vipulgpt10/Digital-IC-Tester-and-Identifier/pics/13120489_1094352060622823_1292871912_o.jpg

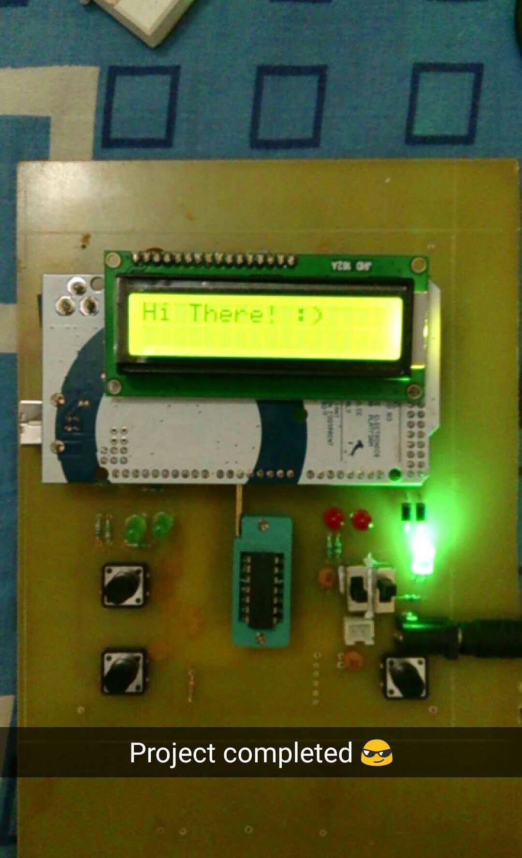
pics/13120489_1094352060622823_1292871912_o.jpg
