vipulgpt10/Digital-IC-Tester-and-Identifier/pics/13120432_1094352113956151_1493493609_o.jpg

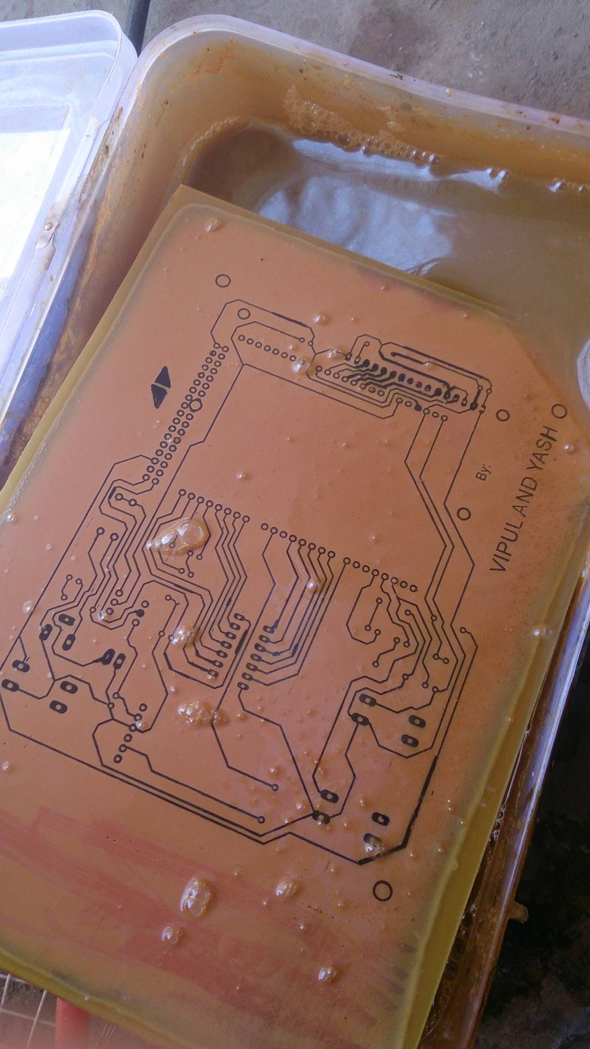
pics/13120432_1094352113956151_1493493609_o.jpg
