vipulgpt10/Digital-IC-Tester-and-Identifier/pics/13106560_1094352093956153_963681279_o.jpg

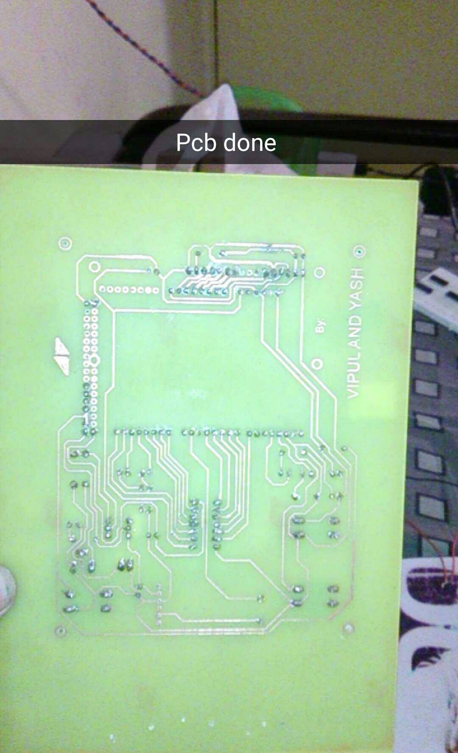
pics/13106560_1094352093956153_963681279_o.jpg
