vipulgpt10/Digital-IC-Tester-and-Identifier/pics/13120357_1094352080622821_129199084_o.jpg

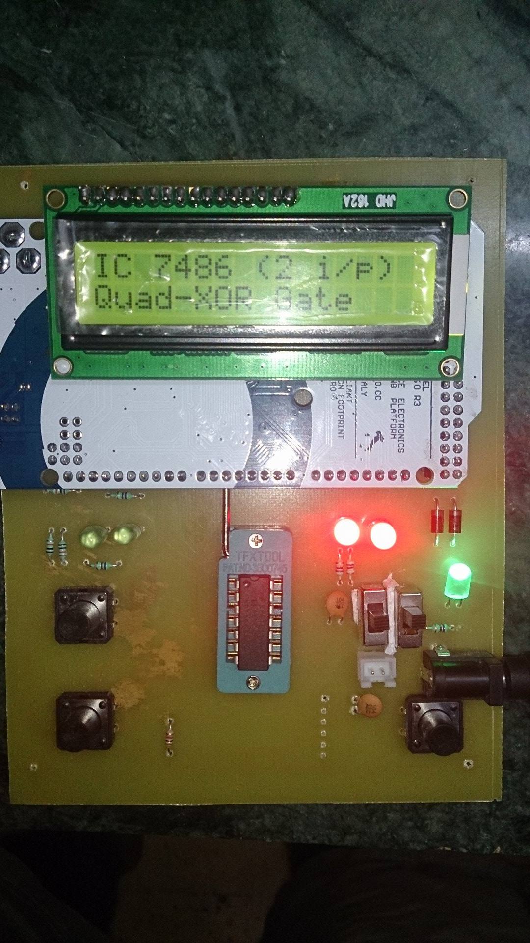
pics/13120357_1094352080622821_129199084_o.jpg
