vipulgpt10/Digital-IC-Tester-and-Identifier/pics/13120414_1094352140622815_749441663_o.jpg

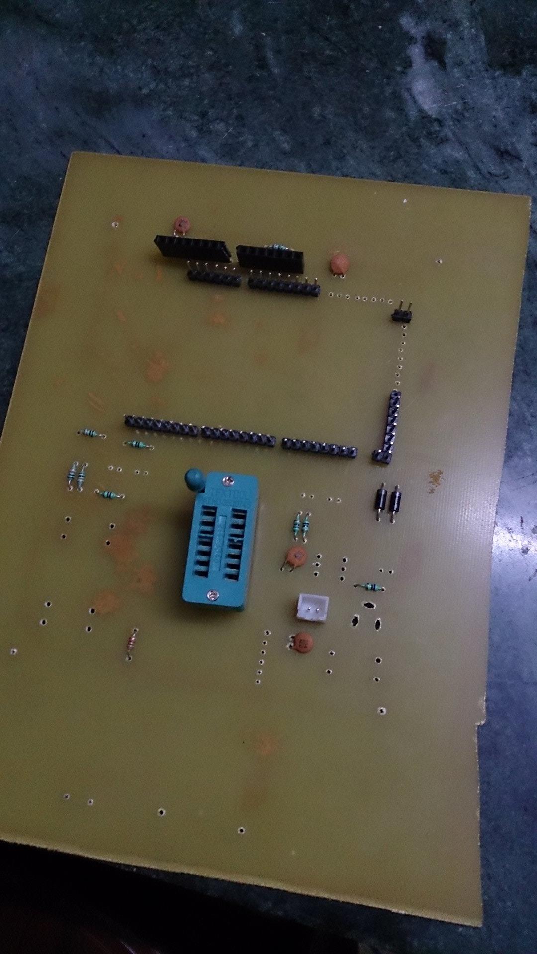
pics/13120414_1094352140622815_749441663_o.jpg
