vipulgpt10/Digital-IC-Tester-and-Identifier/PCB Files/Drill File/IC test1.TXT

%
M48
M72
T01C0.0315
T02C0.0320
T03C0.0354
T04C0.0394
T05C0.0400
T06C0.0440
T07C0.0450
T08C0.0470
T09C0.0710
T10C0.1000
T11C0.1260
%
T01
X37600Y11990
X38781Y10100
T02
X38850Y13850
X38350Y15850
X39350Y15850
X35850Y13850
X29850Y17850
X28850Y17850
X28850Y20850
X29850Y20850
X29850Y22850
X28850Y22850
X31850Y22850
X32850Y22850
X28850Y14350
X27850Y14350
X22850Y13850
X22850Y12850
X22850Y14850
X22850Y15850
X22850Y16850
X22850Y17850
X22850Y18850
X19850Y18850
X19850Y17850
X19850Y16850
X19850Y15850
X19850Y14850
X19850Y13850
X19850Y12850
X13600Y5600
X13600Y2600
X9350Y19850
X8350Y22850
X7350Y22850
X6350Y19850
X4350Y19850
X3350Y19850
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
