vipulgpt10/Digital-IC-Tester-and-Identifier/IC Tester.png

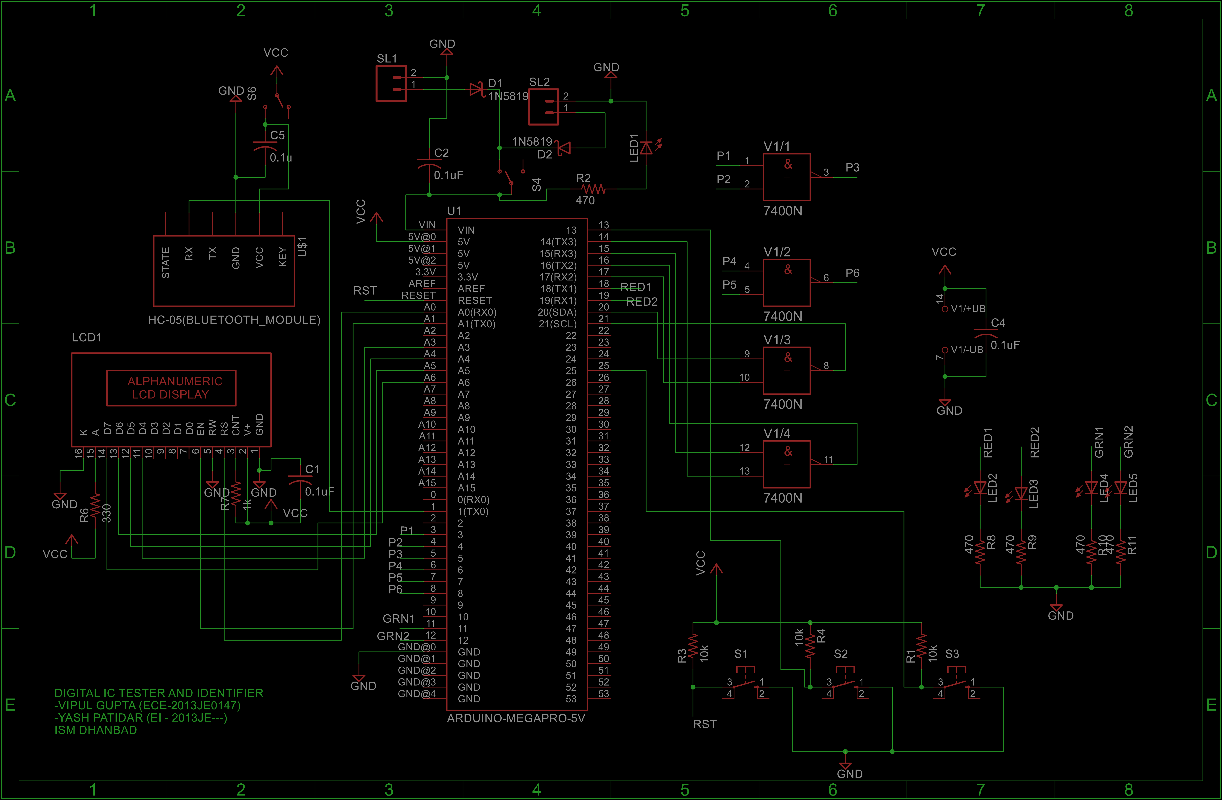
IC Tester.png
