vipulgpt10/Digital-IC-Tester-and-Identifier/IC test1.brd

## EAGLE design IC test1.brd (2016-06-01)

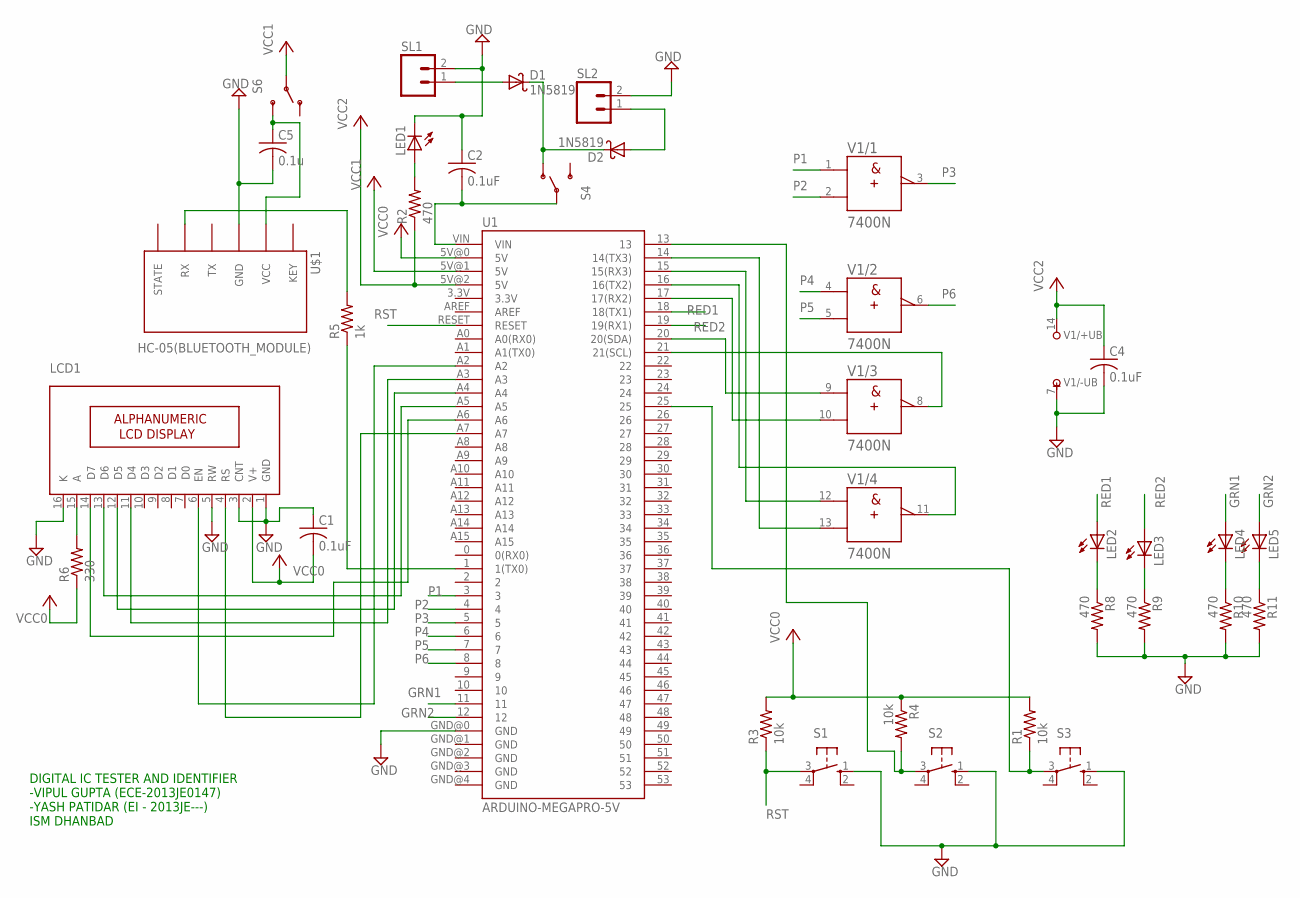
[picture p23: schematic IC test1.sch]

Parts:
C1, C2, C4: 0.1uF; C025-024X044
C5: 0.1u; C025-024X044
D1, D2: 1N5819; DO41-10
LCD1: 16X2LCD; 16X2_LCD
LED1, LED2, LED3, LED4, LED5: LED5MM
R1, R3, R4: 10k; 0204/7
R2, R8, R9, R10, R11: 470; 0204/7
R5: 1k; 0204/7
R6: 330; 0204/7
S1, S2, S3: 40-XX; B3F-40XX
S4, S6: SWITCH-SPDTPTH; SWITCH-SPDT
SL1, SL2: M02; 02P
U1: ARDUINO-MEGAPRO-5V; ARDUINO_MEGA-PRO-5V
U$1: HC-05(BLUETOOTH_MODULE); HC-05
V1: 7400N; DIL14

Connections:
GND: C1.1, C2.1, C4.2, C5.2, LCD1.1 (GND), LCD1.3 (CNT), LCD1.5 (RW), LCD1.16 (K), LED1.K (C), R8.2, R9.2, R10.2, R11.2, S1.1 (S), S2.1 (S), S3.1 (S), SL1.2, SL2.2, U1.GND@0 (GND), U$1.GND, V1.7 (-UB)
GRN1: LED4.A, U1.11
GRN2: LED5.A, U1.12
unnamed: LCD1.15 (A), R6.2
unnamed: R5.2, U$1.RX
unnamed: LCD1.4 (RS), U1.A7
unnamed: LCD1.6 (EN), U1.A2
unnamed: LCD1.11 (D4), U1.A3
unnamed: LCD1.12 (D5), U1.A4
unnamed: LCD1.13 (D6), U1.A5
unnamed: LCD1.14 (D7), U1.A6
unnamed: D1.C, D2.C, S4.1 (O)
unnamed: D2.A, SL2.1
unnamed: C2.2, S4.2, U1.VIN
unnamed: D1.A, SL1.1
unnamed: C5.1, S6.3 (S), U$1.VCC
unnamed: U1.14 (14(TX3)), V1.13 (B)
unnamed: R4.2, S2.3, U1.13
unnamed: R1.1, S3.3, U1.25
unnamed: U1.15 (15(RX3)), V1.12 (A)
unnamed: LED1.A, R2.2
unnamed: U1.16 (16(TX2)), V1.11 (Y)
unnamed: U1.17 (17(RX2)), V1.10 (B)
unnamed: U1.20 (20(SDA)), V1.9 (A)
unnamed: U1.21 (21(SCL)), V1.8 (Y)
unnamed: LED2.K (C), R8.1
unnamed: LED3.K (C), R9.1
unnamed: LED4.K (C), R10.1
unnamed: LED5.K (C), R11.1
unnamed: R5.1, U1.1 (1(TX0))
P1: U1.3, V1.1 (A)
P2: U1.4, V1.2 (B)
P3: U1.5, V1.3 (Y)
P4: U1.6, V1.4 (A)
P5: U1.7, V1.5 (B)
P6: U1.8, V1.6 (Y)
RED1: LED2.A, U1.18 (18(TX1))
RED2: LED3.A, U1.19 (19(RX1))
RST: R3.1, S1.3, U1.RESET
VCC0: C1.2, LCD1.2 (V+), R1.2, R3.2, R4.1, R6.1, U1.5V@0 (5V)
VCC3: R2.1, S6.2, U1.5V@2 (5V)
VCC4: C4.1, U1.5V@1 (5V), V1.14 (+UB)

Notes on the sheet:
DIGITAL IC TESTER AND IDENTIFIER -VIPUL GUPTA (ECE-2013JE0147) -YASH PATIDAR (EI - 2013JE---) ISM DHANBAD

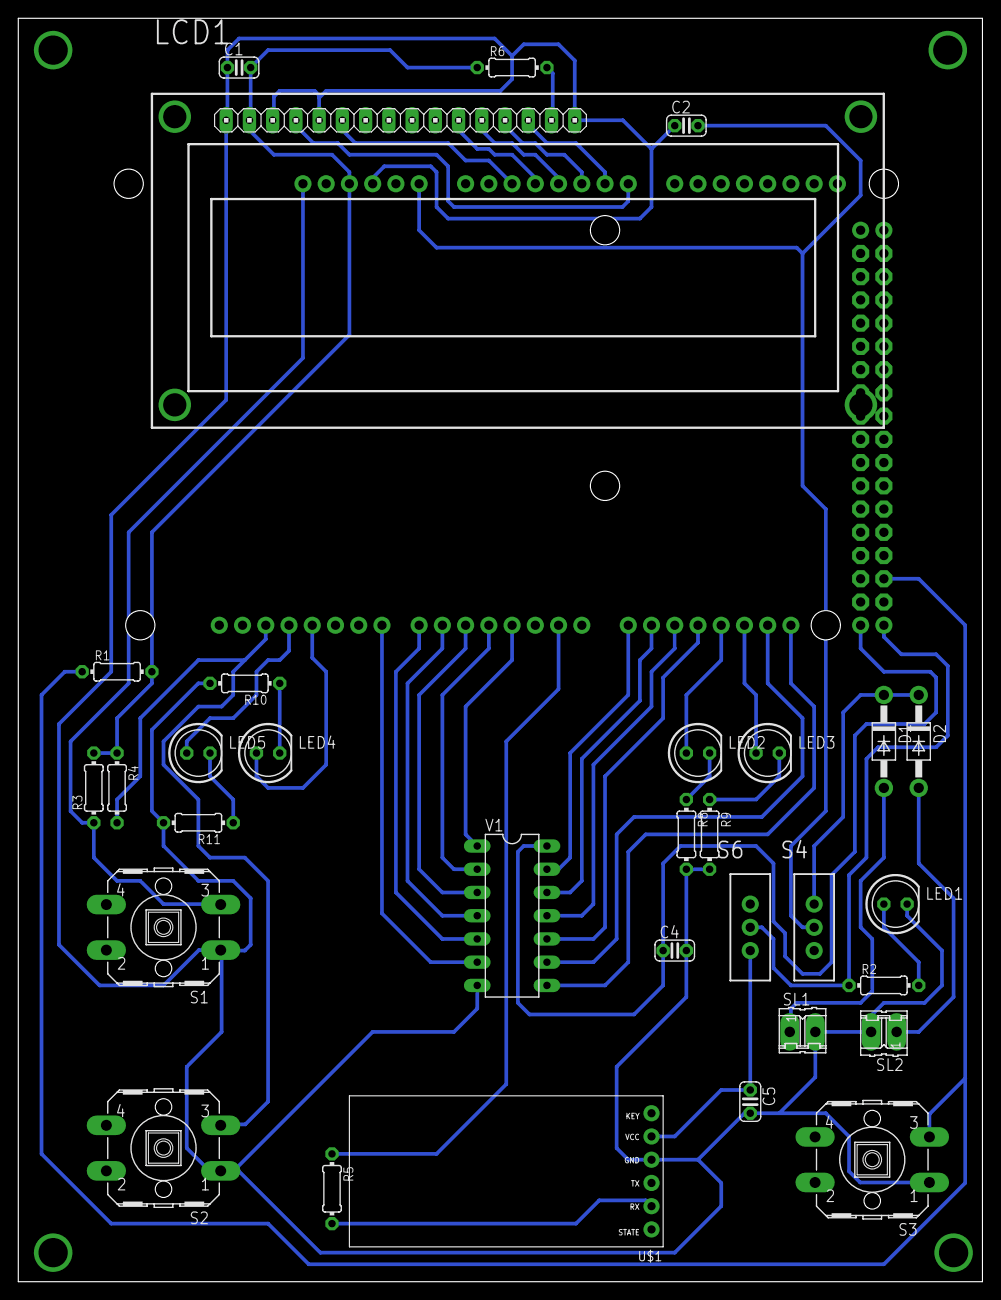
[picture p24: board IC test1.brd from above]

Board: 2 copper layers, 105.4 x 138.1 mm, 32 parts (1 on the bottom side), 42 nets.
